wschuma/TeensyLCR/hardware/PCBA/1.1/BOM_TeensyLCR_R1_v1.1.csv

Name | Designator | Footprint | Quantity | Manufacturer Part | Manufacturer
100nF | C1,C2,C3,C4,C5,C6,C7,C8,C9,C10,C11,C12,C21,C22,C23,C24,C25,C26,C27,C28,C31,C34,C35,C39,C43,C58,C59 | C0603 | 27 | CC0603KRX7R9BB104 | YAGEO(国巨)
NP | C13,C14,C15,C16 | C0603 | 4
750pF | C17,C19 | C0603 | 2 | CC0603JRNPO9BN751 | YAGEO(国巨)
180pF | C18,C20 | C0603 | 2 | CC0603JRNPO9BN181 | YAGEO(国巨)
47uF | C29,C32,C37 | CAP-SMD_BD6.3-L6.6-W6.6-LS7.3-FD | 3 | XT47UF50V90RV0082 | KNSCHA(科尼盛)
1uF | C30,C33,C36,C53,C54,C57 | C1206 | 6 | CL31B105KBHNNNE | SAMSUNG(三星)
10uF | C38,C40,C41,C52,C55,C56 | C1206 | 6 | CL31A106KBHNNNE | SAMSUNG(三星)
10nF | C42 | C0603 | 1 | 0603B103K500NT | FH(风华)
33pF | C44,C45 | C0603 | 2 | CL10C120JB8NNNC | SAMSUNG(三星)
2.7nF | C46,C51 | C0603 | 2 | CC0603JRNPO9BN272 | YAGEO(国巨)
470pF | C47,C48,C49,C50 | C0603 | 4 | CC0603JRNPO9BN471 | YAGEO(国巨)
BAV199 | D1,D2,D3,D4,D5 | TSOT23-3 | 5 | BAV199LT1G | onsemi(安森美)
B360A | D6,D7,D8 | SMA_L4.4-W2.6-LS5.0-RD | 3
4-103321-5 | H5,JP2 | HDR-TH_3P-P2.54-V-M | 2 | 4-103321-5 | TE Connectivity(美国泰科)
828214-2 | JP1 | HDR-TH_2P-P2.54-V-M | 1 | 828214-2 | TE Connectivity(美国泰科)
6.8uH | L1,L2 | IND-SMD_L4.0-W4.0 | 2 | YNR4018-6R8M | YJYCOIN(益嘉源)
100Ω@100MHz | L3 | L0805 | 1 | GZ2012D101TF | Sunlord(顺络)
600Z | L4 | L1206 | 1 | L1206 | null
19-213/Y2C-CQ2R2L/3T(CY) | LED1 | LED0603-RD-YELLOW | 1 | 19-213/Y2C-CQ2R2L/3T(CY) | EVERLIGHT(亿光)
19-217/GHC-YR1S2/3T | LED2 | LED0603-RD | 1 | 19-217/GHC-YR1S2/3T | EVERLIGHT(亿光)
1812L014 | PTC1,PTC2,PTC3,PTC4 | F1812 | 4
2N7002 | Q1 | SOT-23-3_L2.9-W1.3-P1.90-LS2.4-BR | 1 | 2N7002 | CJ(江苏长电/长晶)
LBSS84LT1G | Q2 | SOT-23_L2.9-W1.3-P1.90-LS2.4-BR | 1 | LBSS84LT1G | LRC(乐山无线电)
10kΩ | R1,R2,R11,R12,R18,R19 | R0603 | 6 | 0603WAF1002T5E | UNI-ROYAL(厚声)
100Ω | R3,R7,R38 | R0805 | 3 | 0805W8F1000T5E | UNI-ROYAL(厚声)
1kΩ | R4,R8 | R0805 | 2 | 0805W8F1001T5E | UNI-ROYAL(厚声)
10kΩ | R5,R9 | R0805 | 2 | 0805W8F1002T5E | UNI-ROYAL(厚声)
100kΩ | R6,R10 | R0805 | 2 | 0805W8F1003T5E | UNI-ROYAL(厚声)
10kΩ | R13,R14,R15,R16,R20,R21,R22,R23,R34,R35,R36,R37,R41,R67 | R0603 | 14 | RT0603BRD0710KL | YAGEO(国巨)
22Ω | R17 | R0603 | 1 | 0603WAF220JT5E | UNI-ROYAL(厚声)
27kΩ | R24,R70 | R0603 | 2 | RT0603BRD0710KL | YAGEO(国巨)
5.1kΩ | R25,R71 | R0603 | 2 | RT0603BRD072K05L | YAGEO(国巨)
1kΩ | R26,R29 | R0603 | 2 |  | YAGEO(国巨)
330Ω | R27,R28 | R0603 | 2 |  | YAGEO(国巨)
15kΩ | R30,R32 | R0603 | 2 | RT0603BRD0715KL | YAGEO(国巨)
7.5kΩ | R31,R33 | R0603 | 2 | RT0603BRD077K5L | YAGEO(国巨)
13kΩ | R39 | R0603 | 1 | 0603WAF1302T5E | UNI-ROYAL(厚声)
68kΩ | R40 | R0603 | 1 | 0603WAF6802T5E | UNI-ROYAL(厚声)
30.9kΩ | R42 | R0603 | 1 | ARG03FTC3092 | Viking(光颉)
39Ω | R43,R44,R56,R57 | R0603 | 4 | TC0325B390JT5E | UNI-ROYAL(厚声)
560Ω | R45,R53,R54,R58 | R0603 | 4 | RT0603BRD07560RL | YAGEO(国巨)
NP | R46,R47,R48,R49 | R0603 | 4 | 0603WAF1004T5E | UNI-ROYAL(厚声)
1kΩ | R50,R51,R52,R55 | R0603 | 4 | RT0603BRD071KL | YAGEO(国巨)
4.7kΩ | R59,R60 | R0603 | 2 | 0603WAF4701T5E | UNI-ROYAL(厚声)
NP | R61,R62,R63,R64,R65 | R0603 | 5 | 0603WAF1002T5E | UNI-ROYAL(厚声)
1.8kΩ | R68 | R0603 | 1 | 0603WAF1801T5E | UNI-ROYAL(厚声)
470Ω | R69,R72 | R0603 | 2 | 0603WAF4700T5E | UNI-ROYAL(厚声)
1kΩ | R73 | R0603 | 1 | 0603WAF4700T5E | UNI-ROYAL(厚声)
10k | R74,R75 | R0603 | 2 | 0603WAF1002T5E | UNI-ROYAL(厚声)
62kΩ | R76 | R0603 | 1 | 0603WAF6202T5E | UNI-ROYAL(厚声)
8.2kΩ | R77 | R0603 | 1 | RT0603BRD0710KL | YAGEO(国巨)
NO | SB1,SB2,SB3,SB4,SB5 | PAD-JUMPER-2-NO_YES_SILK | 5
5002 | TP1,TP2,TP3,TP4,TP5,TP6,TP7,TP8,TP9,TP10,TP11 | KEYSTONE5002 | 11 |  | Keystone
OPA192ID | U1,U4,U12 | SOIC-8_L4.9-W3.9-P1.27-LS6.0-BL | 3
MAX4582CSE | U2,U3 | SOIC-16_L9.9-W3.9-P1.27-LS6.0-BL | 2 | 74VHC4052N | onsemi(安森美)
MAX4052ACSE | U9,U10 | SOIC-16_L9.9-W3.9-P1.27-LS6.0-BL | 2 | 74VHC4052N | onsemi(安森美)
CS4272-CZZ | U11 | TSSOP-28_L9.7-W4.4-P0.65-LS6.4-TL | 1
M24C02-WMN6TP | U13 | SOIC-8_L4.9-W3.9-P1.27-LS6.0-BL | 1 | M24C02-WMN6TP | ST(意法半导体)
Teensy4.1 | U14 | TEENSY4.1 | 1 | Teensy4.1 | PJRC
ADP2301 | U15,U19 | TSOT-23-6_L2.9-W1.6-P0.95-LS2.8-BL | 2 | ADP2301AUJZ-R7 | ADI
LT1962 | U17 | MSOP-8 | 1
AMS1117-5.0 | U18 | SOT-223_L6.5-W3.5-P2.30-LS7.0-BR_ST_VNL5050N3TR-E | 1 | AMS1117-5.0 | AMS
TCN75AVOA | U20 | SOIC-8_L4.9-W3.9-P1.27-LS6.0-BL | 1 | TCN75AVOA | MICROCHIP(美国微芯)
5414907-1 | X1,X2,X3,X4 | BNC-TH_5414907-1 | 4 | 5414907-1 | TE Connectivity(美国泰科)
DC-005-5A-2.0 | X5 | DC-IN-TH_DC-005-5A-2.0 | 1 | DC-005-5A-2.0 | XKB Enterprise
MKDSN1.5/2-5.08 | X6 | CONN-TH_2P-P5.08 | 1 | 1729128 | Phoenix Contact(菲尼克斯)
0423751867 | X7 | HDR-TH_14P-P2.54-V-M | 1 | 0423751867 | MOLEX
827261-8 | X8 | HDR-TH_8P-P2.54-V-M | 1 | 827261-8 | TE Connectivity(美国泰科)
5-146282-5 | X9 | HDR-TH_5P-P2.54-V-M | 1 | 5-146282-5 | TE Connectivity(美国泰科)
0022102041 | X10 | HDR-TH_4P-P2.54-V-M | 1 | 0022102041 | MOLEX
0878910609 | X11 | HDR-TH_6P-P2.54-V-M | 1 | 0878910609 | MOLEX
24.576MHz | Y1 | CRYSTAL-TXC-7A | 1
OPA2192ID | U5,U6 | SOIC-8_L4.9-W3.9-P1.27-LS6.0-BL | 2 | OPA2376AIDR | TI(德州仪器)
AD8032ARZ | U7,U8 | SOIC-8_L4.9-W3.9-P1.27-LS6.0-BL | 2 | OPA2376AIDR | TI(德州仪器)
THS4522IPW | U16 | TSSOP-16_L5.0-W4.4-P0.65-LS6.4-TL | 1
