wschuma/TeensyLCR/hardware/PCBA/1.1/Schematic_TeensyLCR_R1_v1.1.pdf

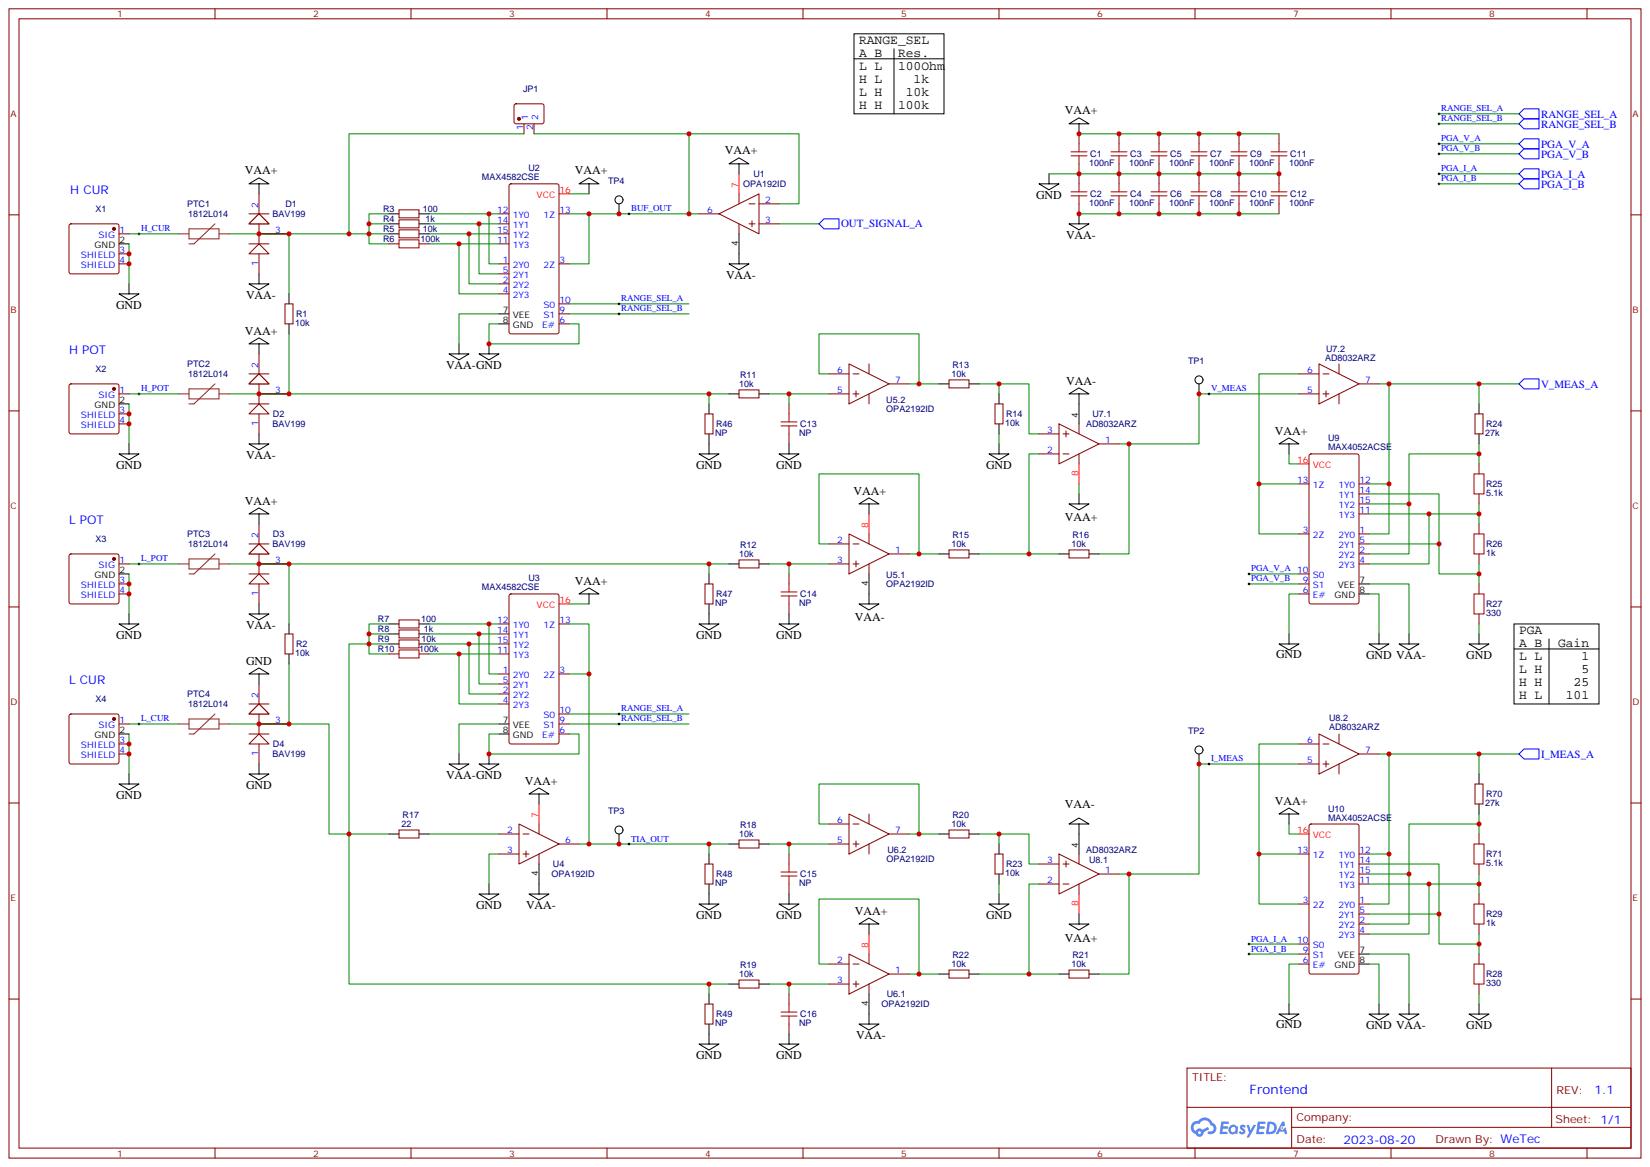
[picture p5: page 1]

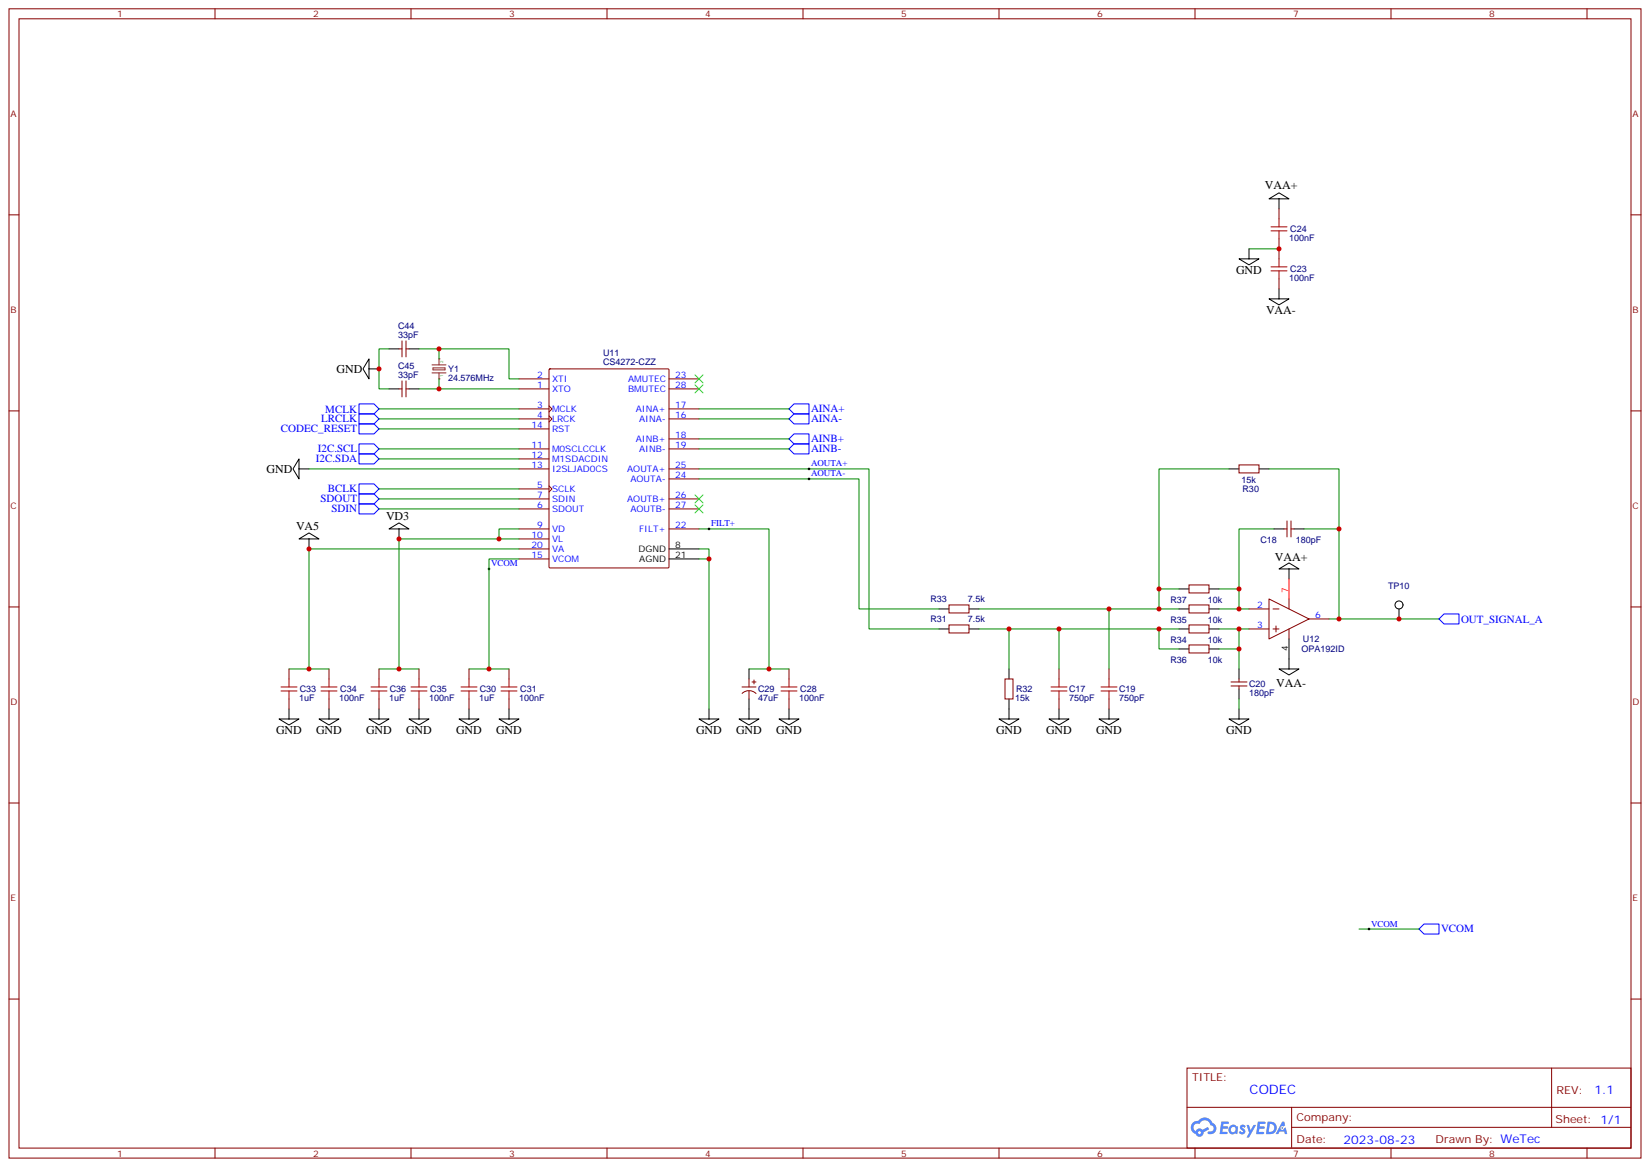
[picture p6: page 2]

# VD5 rail

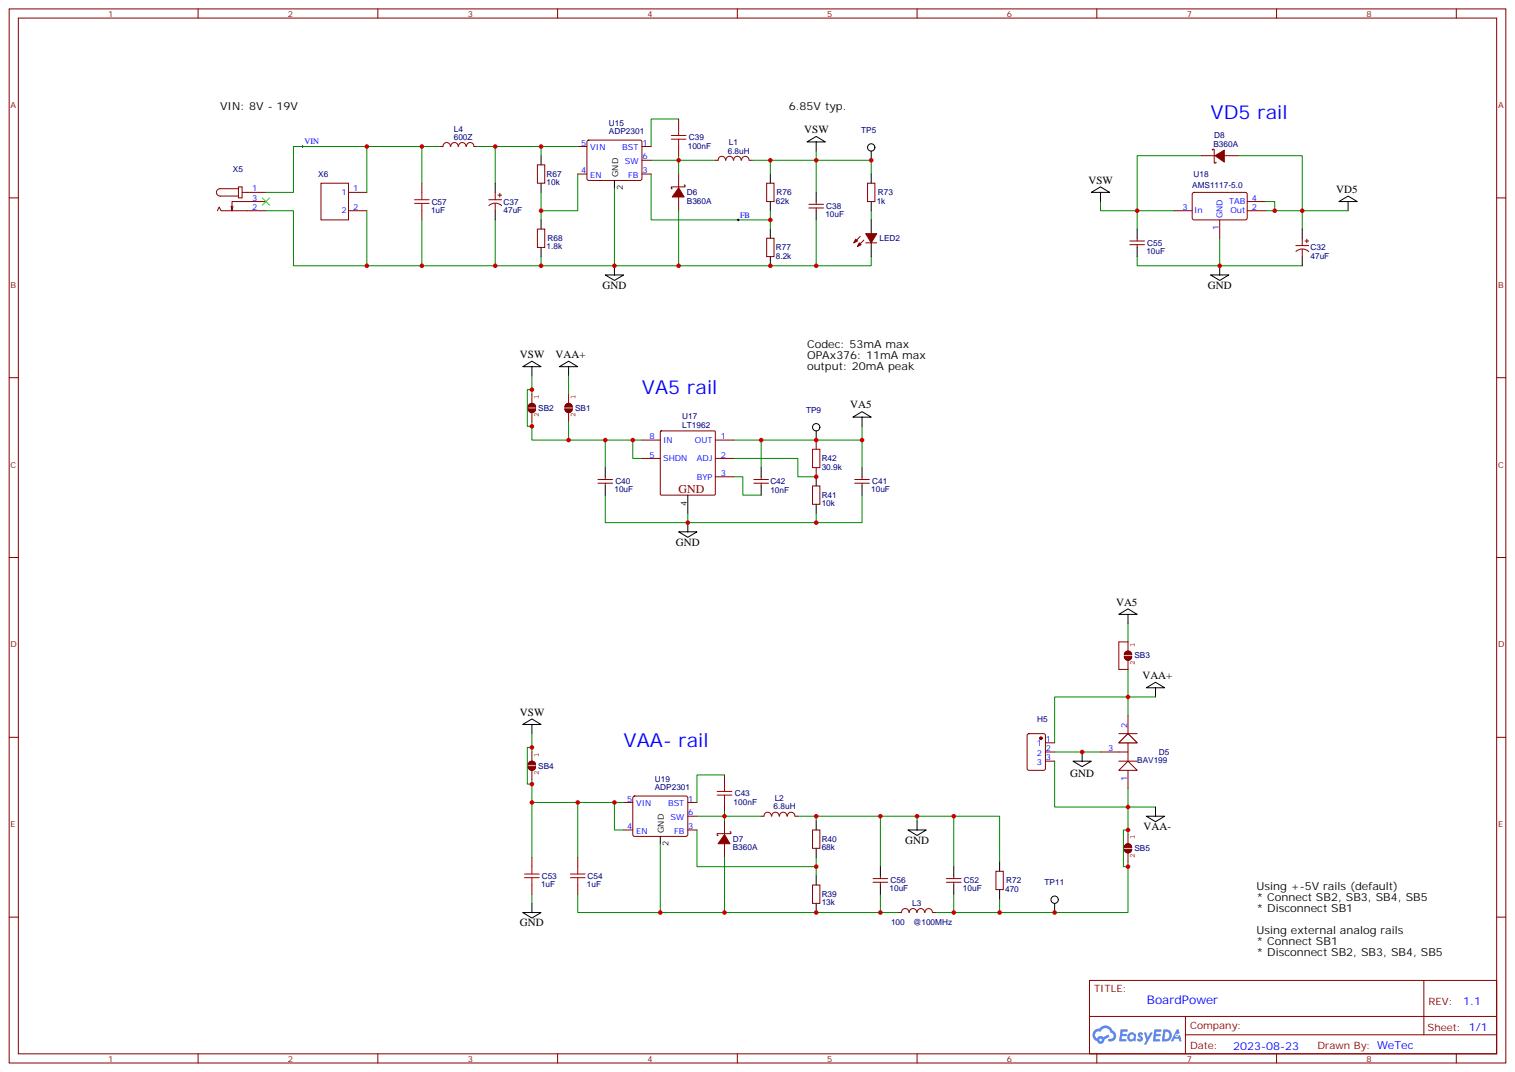
[picture p7: page 3]

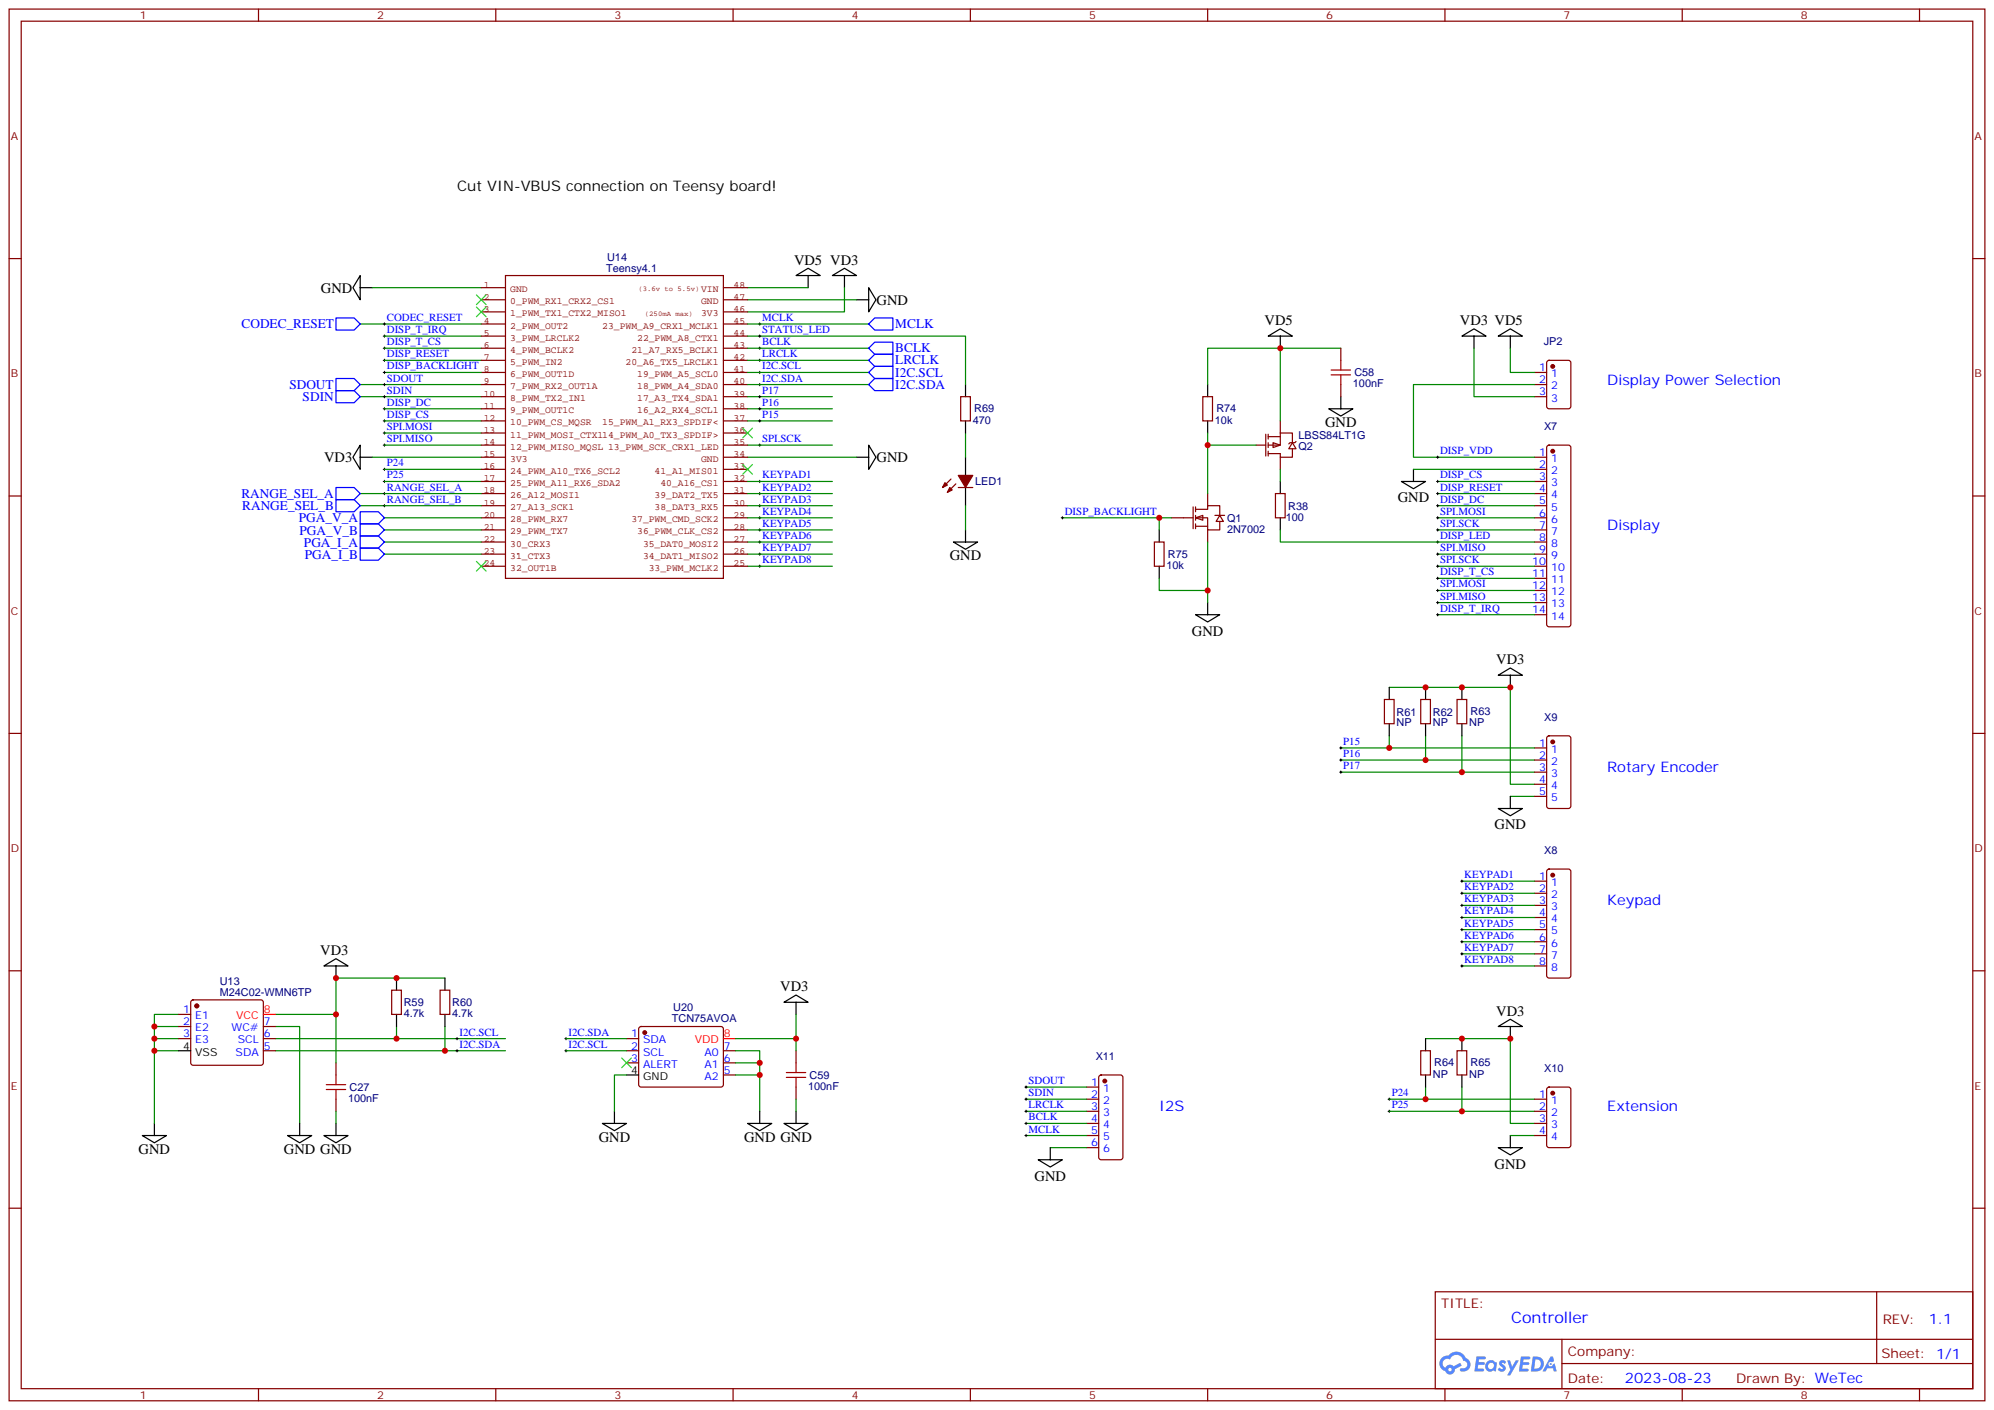
[picture p8: page 4]

Cut VIN-VBUS connection on Teensy board!

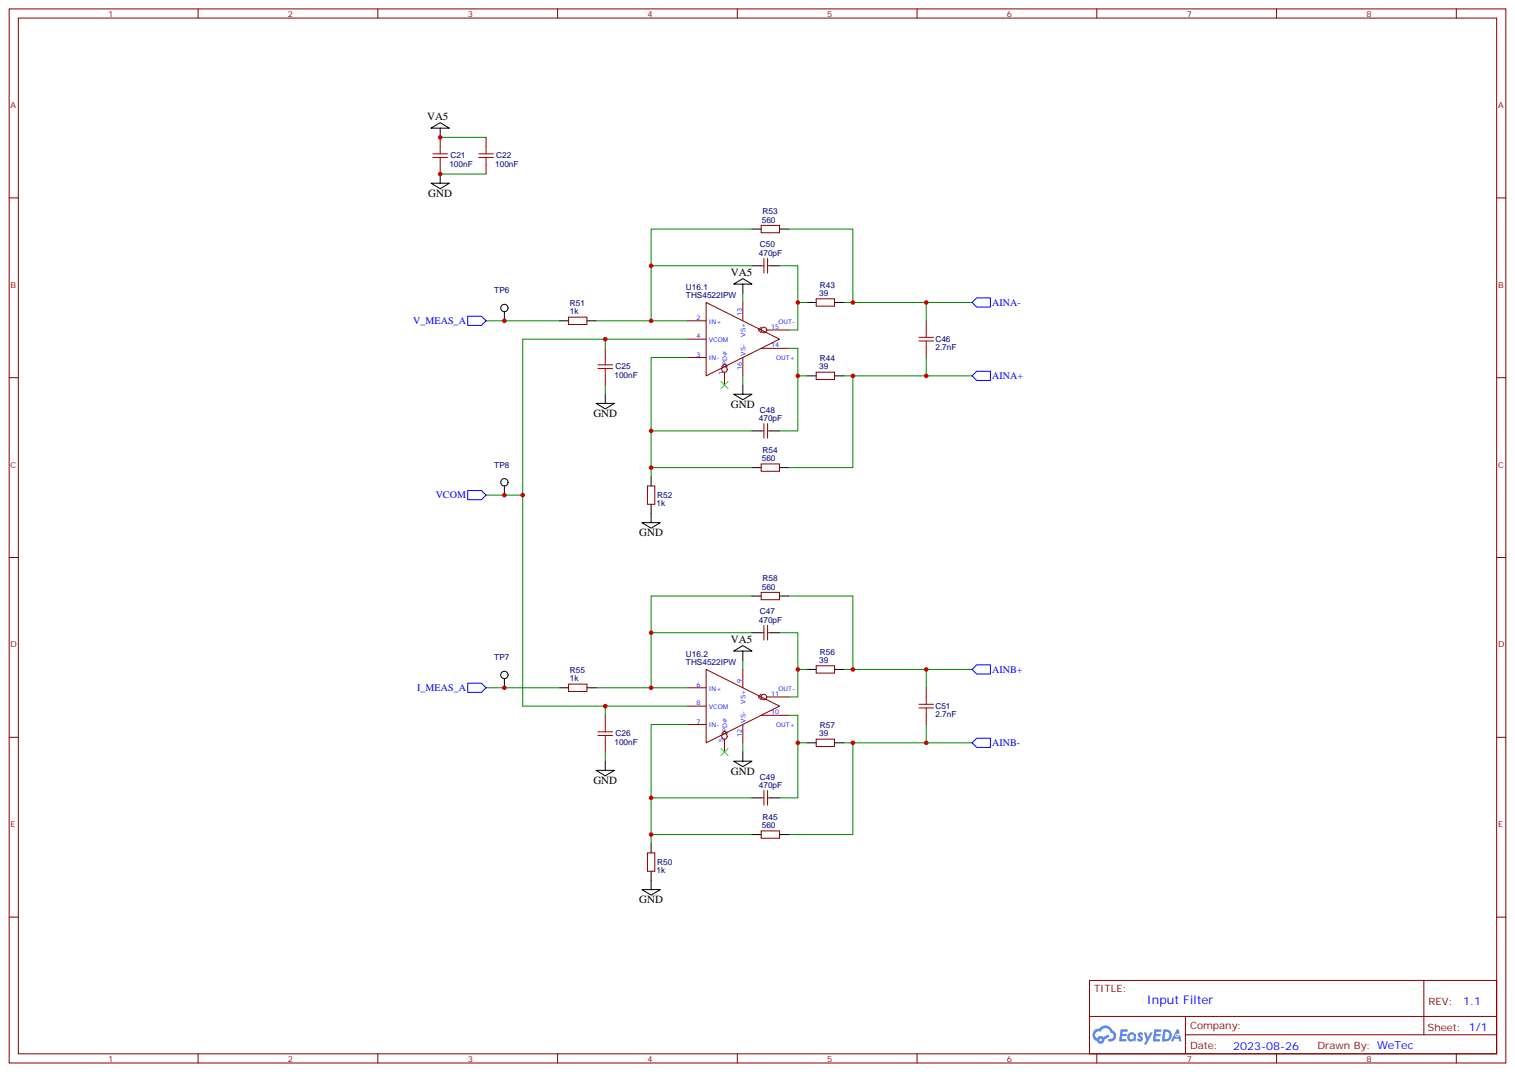
[picture p9: page 5]
