wschuma/TeensyLCR/hardware/PCBA/1.0/Schematic_TeensyLCR_R1_v1.0.pdf

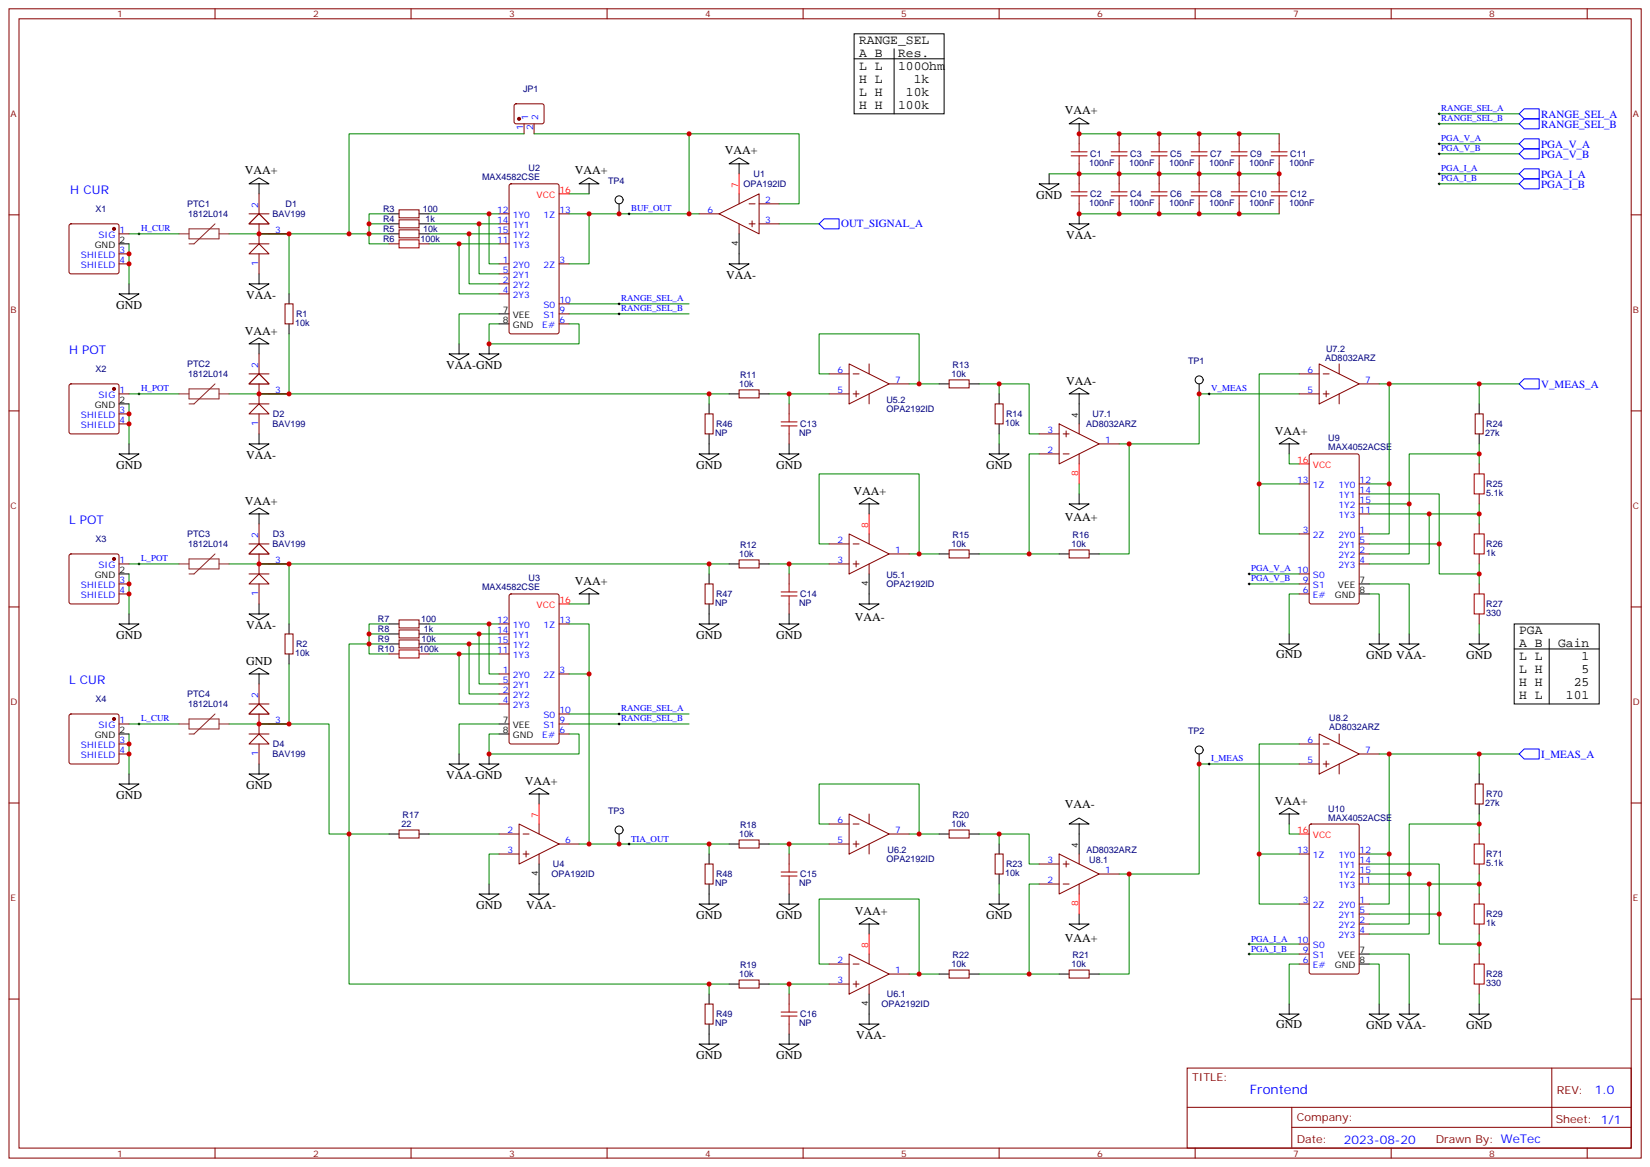
[picture p10: page 1]

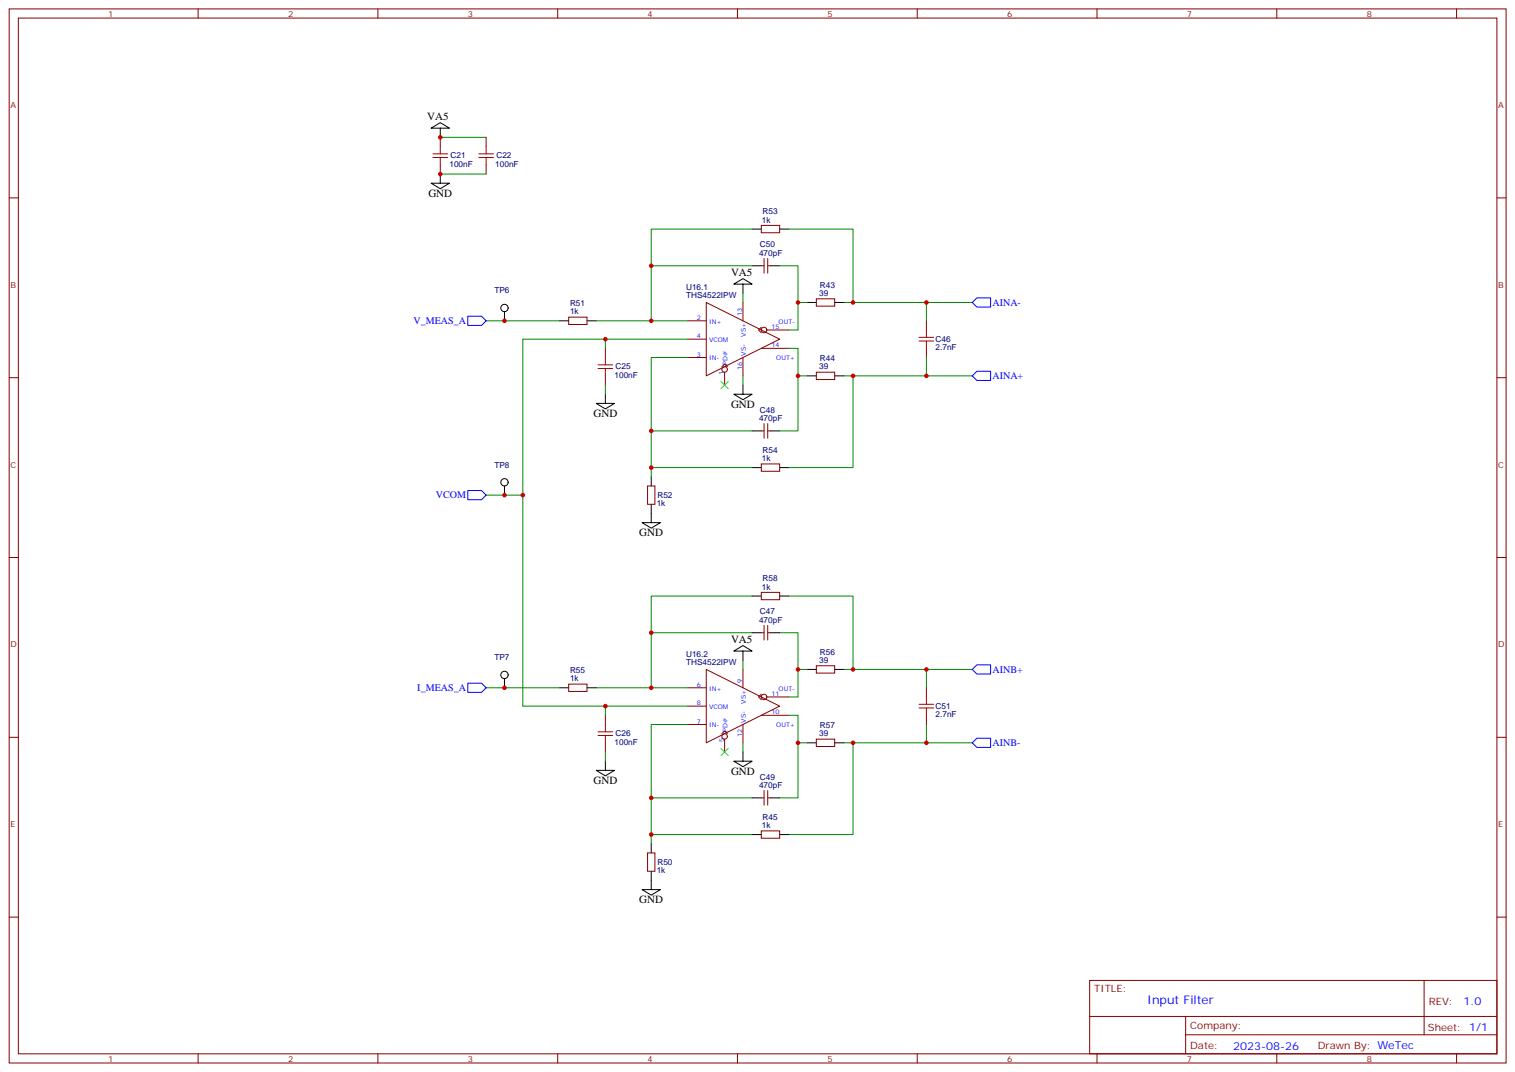
[picture p11: page 2]

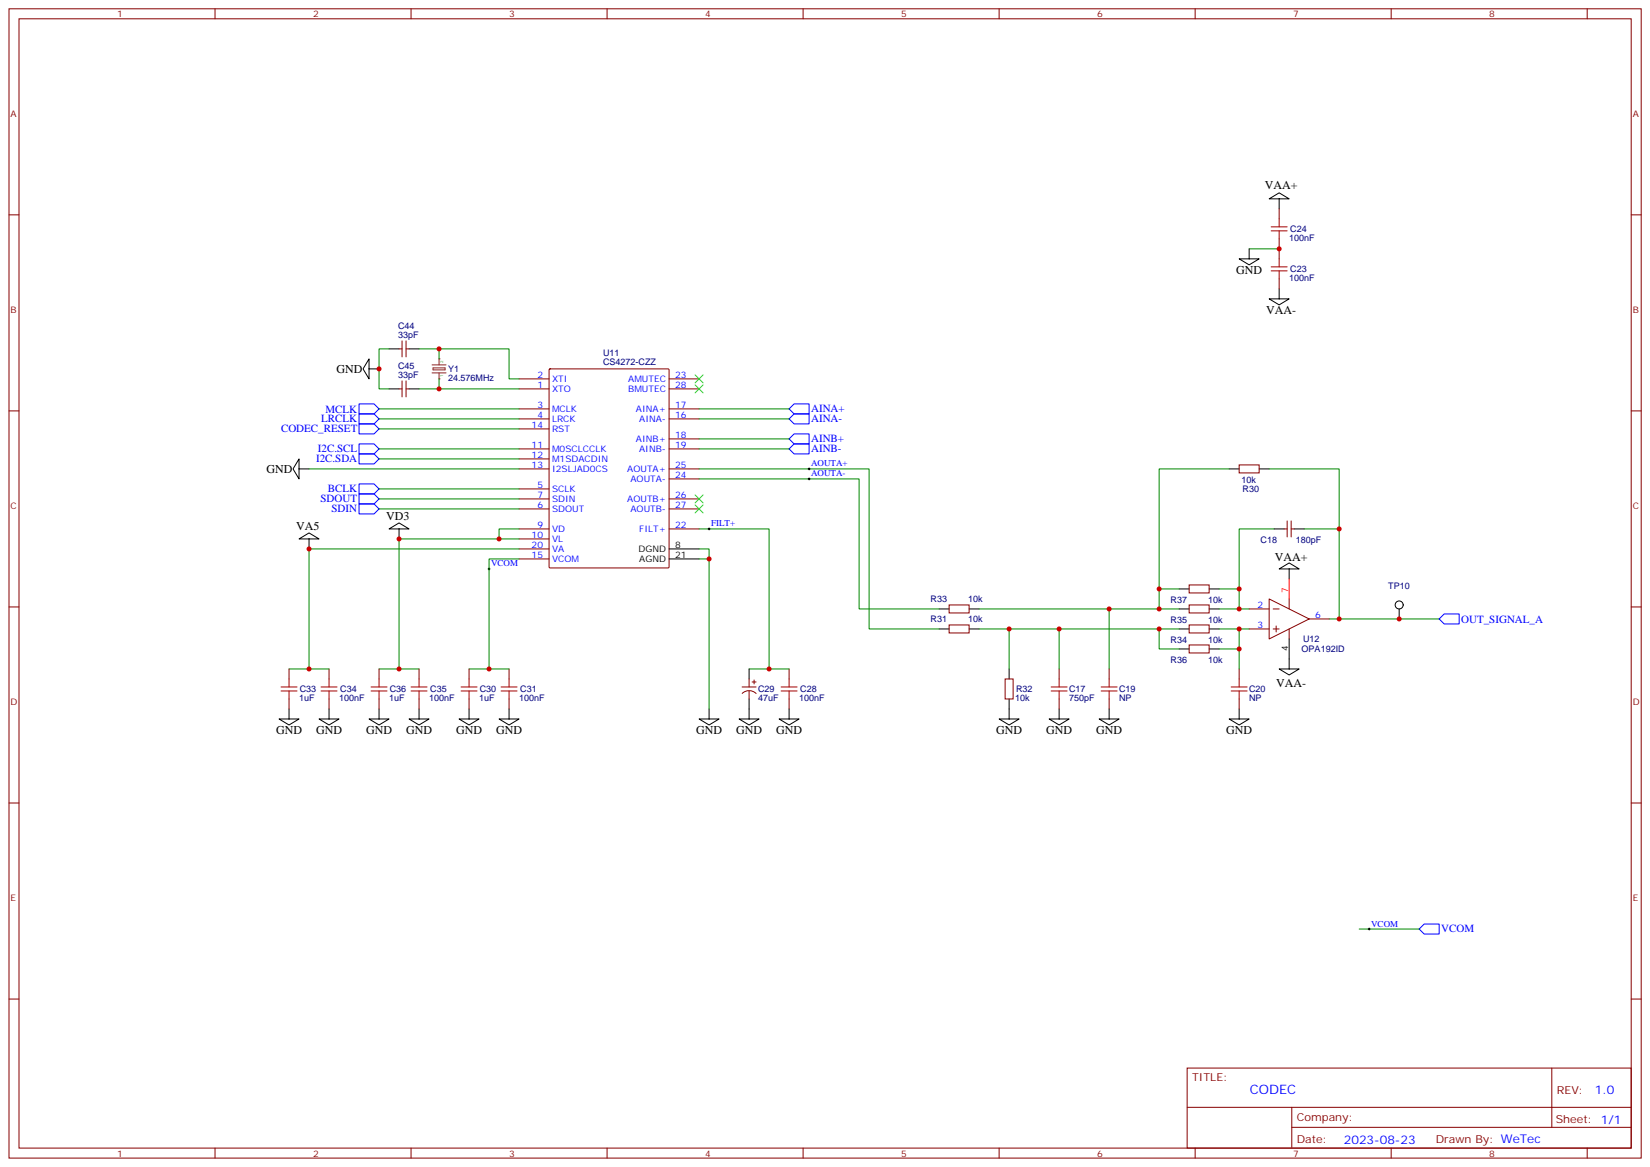
[picture p12: page 3]

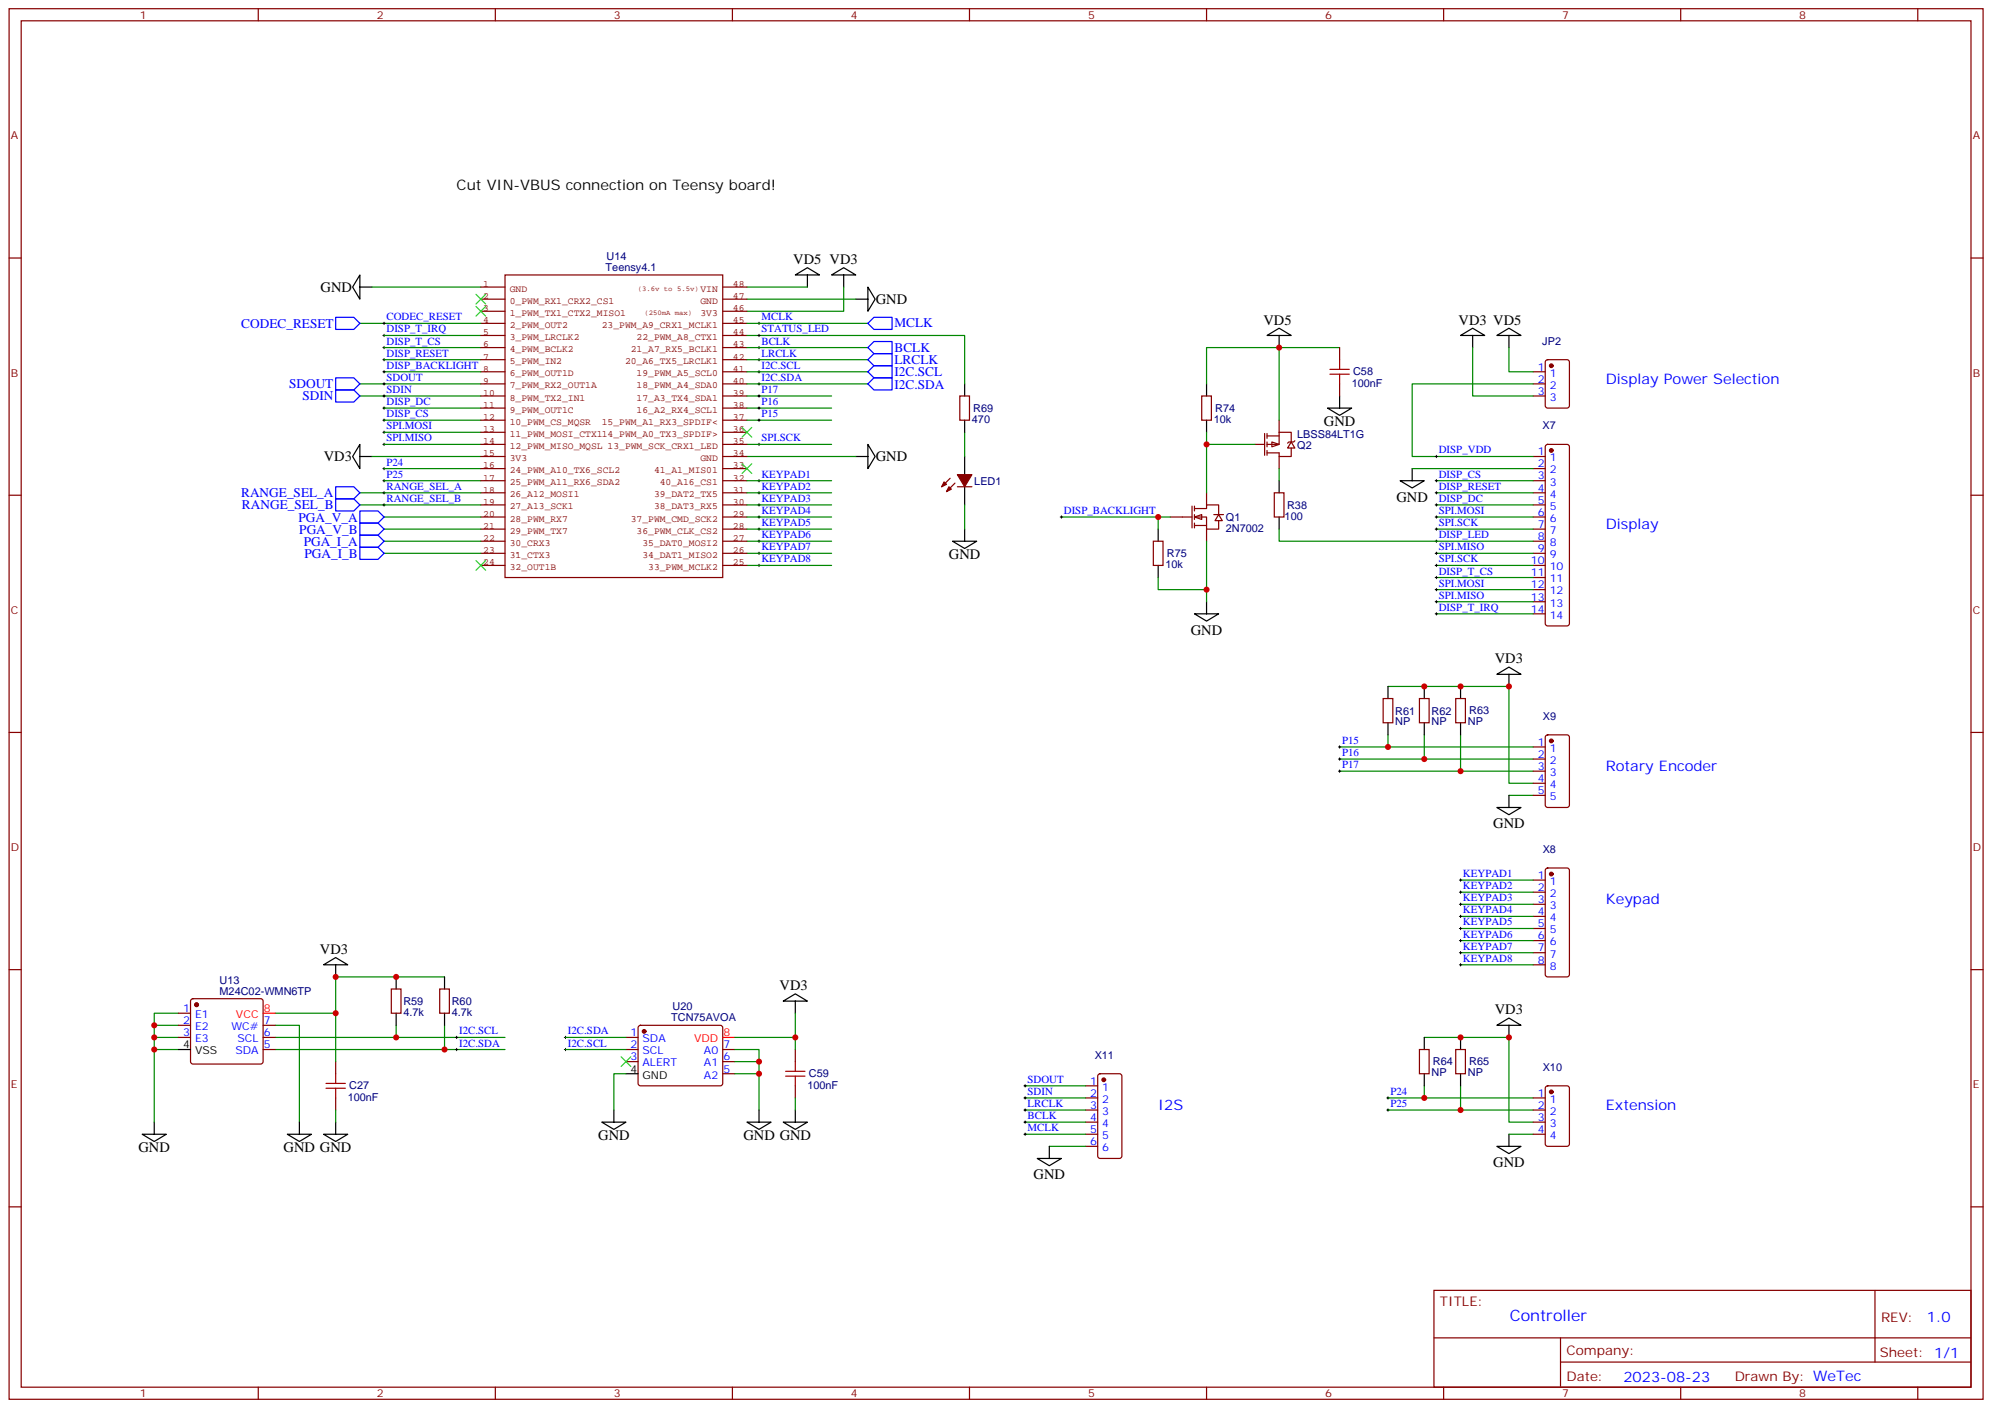
[picture p13: page 4]

Cut VIN-VBUS connection on Teensy board!

# VD5 rail

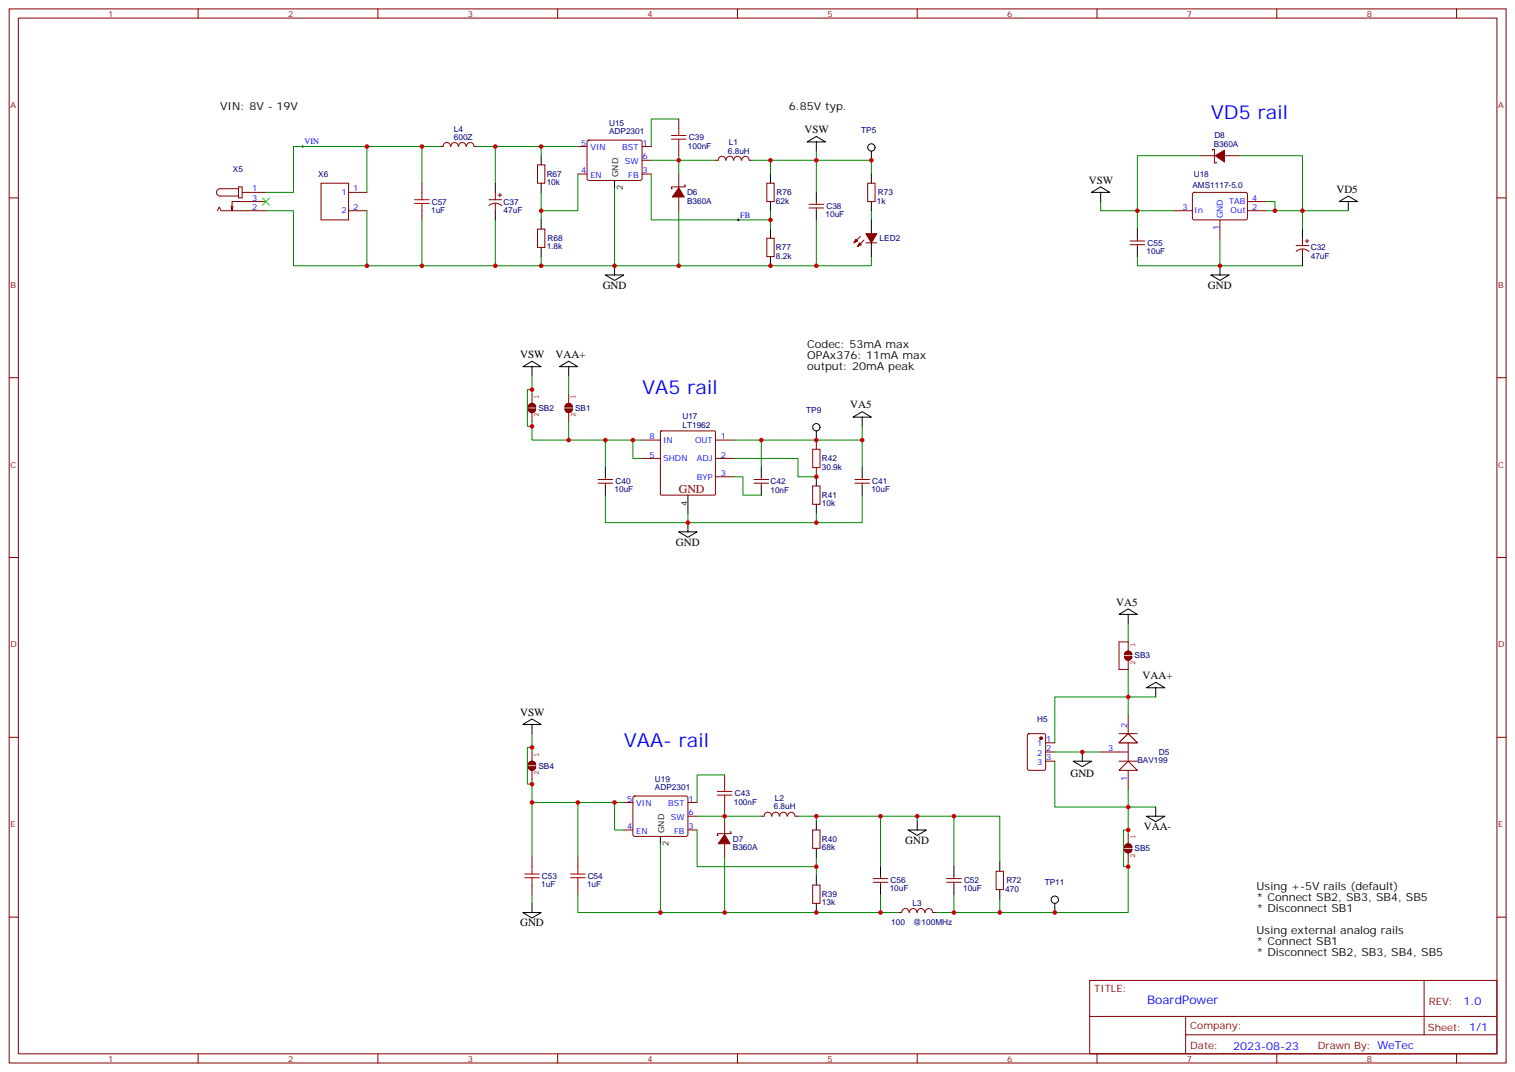
[picture p14: page 5]
