wschuma/TeensyLCR/func_lcr.cpp

#include "apps.h"
#include <Arduino.h>
#include "audio_design.h"
#include "autorange.h"
#include "board.h"
#include "CComplex.h"
#include "correction.h"
#include "displayhelp.h"
#include "func_lcr.h"
#include "globals.h"
#include "helper.h"
#include <ili9341_t3n_font_Arial.h>
#include "lcr_param.h"
#include "lcr_setup.h"
#include "settings.h"
#include "src/utils/btn_bar_menu.h"
#include "sweep.h"
#include "sysmenu.h"

static const uint8_t PRIMARY = 0;
static const uint8_t SECONDARY = 1;

bool forceRanging = false;

// Menu definition
BtnBarMenu lcrMenu(&tft);
BtnBarMenu lcrSetFreqMenu(&tft);
BtnBarMenu lcrSetLevelMenu(&tft);

const char *functionLabelSelection;

const char *displModeLabels[] = {"Normal", "Debug"};
const char *displModeLabelSelection;

const char *rangeModeLabels[] = {"Auto", "Hold"};
const char *rangeModeLabelSelection;

const char *offOnLabels[] = {"OFF", "ON"};
const char *corrLabelSelection;
bool applyCorrection = false;

char avgStr[6];

File waveFile;

void lcrDrawFuncIndicators()
{
  // skip if debug display
  if (lcrSettings.displMode != 0)
    return;

  tft.fillRect(0, MAIN_DISPLAY_Y_PRIMARY, 31, 14, ILI9341_BLACK);
  tft.setFont(Arial_14);
  tft.setTextColor(ILI9341_GREEN);
  tft.setCursor(0, MAIN_DISPLAY_Y_PRIMARY);
  tft.print(lcrParams[lcrSettings.function][PRIMARY]->label);

  tft.fillRect(0, MAIN_DISPLAY_Y_SECONDARY, 31, 14, ILI9341_BLACK);
  tft.setCursor(0, MAIN_DISPLAY_Y_SECONDARY);
  tft.print(lcrParams[lcrSettings.function][SECONDARY]->label);
}

void lcrUpdateCorrState()
{
  if (lcrSettings.applyCorrection && (corr_data.ts_open > 0 || corr_data.ts_short > 0))
  {
    corrLabelSelection = offOnLabels[1];
    applyCorrection = true;
  } else {
    corrLabelSelection = offOnLabels[0];
    applyCorrection = false;
  }
}

void lcrDrawMeasSetup()
{
  // skip if debug display
  if (lcrSettings.displMode != 0)
    return;

  static const uint MEAS_SETUP_LINE1_Y = 123;
  static const uint MEAS_SETUP_LINE2_Y = 145;

  // clear area
  tft.fillRect(0, MEAS_SETUP_LINE1_Y, 320, 40, ILI9341_BLACK);
  // draw labels
  tft.setFont(Arial_14);
  tft.setTextColor(ILI9341_GREEN);
  tft.setCursor(0, MEAS_SETUP_LINE1_Y);
  tft.print("FREQ:");
  tft.setCursor(0, MEAS_SETUP_LINE2_Y);
  tft.print("LEVEL:");
  tft.setCursor(163, MEAS_SETUP_LINE1_Y);
  tft.print("RANGE:");
  //tft.print("FUNC:");
  tft.setCursor(163, MEAS_SETUP_LINE2_Y);
  tft.print("CORR:");

  // draw values
  tft.setTextColor(ILI9341_WHITE);

  tft.setCursor(72, MEAS_SETUP_LINE1_Y);
  if (lcrSettings.frequency < 1000) {
    tft.print(lcrSettings.frequency, 0);
    tft.print(" Hz");
  } else {
    tft.print(lcrSettings.frequency / 1000, 2);
    tft.print(" kHz");
  }

  tft.setCursor(72, MEAS_SETUP_LINE2_Y);
  tft.print(lcrSettings.level, 3);
  tft.print(" V");

  tft.setCursor(244, MEAS_SETUP_LINE1_Y);
  //tft.print(functionLabels[lcrSettings.function]);
  tft.print("[");
  tft.print(board.getLCRRange());
  tft.print("] ");
  tft.print(rangeModeLabels[lcrSettings.range_mode]);

  tft.setCursor(244, MEAS_SETUP_LINE2_Y);
  tft.print(corrLabelSelection);
}

void calc_lcr() {
  static const float LCR_THRESHOLD_OPEN = 100e6; // Ohm

  // determain lcr meter range
  bool hold = lcrSettings.range_mode == 1;
  RangingState state = autoRange(hold, forceRanging);
  switch (state) {
    case (RangingState::Started):
      // ranging started
      forceRanging = false;
      drawPrimaryDisplay(" -----");
      drawSecondaryDisplay(" -----");
      return;
    case (RangingState::Active):
      // ranging is active, readings are not valid yet
      return;
    case (RangingState::Finished):
      // finished ranging, restore averaging
      adSetMinAveraging(lcrSettings.minAveraging);
      lcrDrawMeasSetup();
      return;
    default:
      // active range is ok, show results
      break;
  }

  float impedance = adReadings.v_rms / adReadings.i_rms;
  float phase = adReadings.phase;

  if (applyCorrection)
    corrApply(&impedance, &phase, lcrSettings.frequency);

  if (impedance > LCR_THRESHOLD_OPEN)
  {
    drawPrimaryDisplay(" Open");
    drawSecondaryDisplay("");
    return;
  }

  Complex z;
  z.polar(impedance, phase);
  disp_val_t val;
  
  float value = lcrParams[lcrSettings.function][PRIMARY]->value(z, lcrSettings.frequency);
  int8_t resolution = lcrParams[lcrSettings.function][PRIMARY]->resolution;
  getDisplValue(value, 5, resolution, &val);
  val.unit = lcrParams[lcrSettings.function][PRIMARY]->unit;
  drawPrimaryDisplay(&val);
  
  value = lcrParams[lcrSettings.function][SECONDARY]->value(z, lcrSettings.frequency);
  resolution = lcrParams[lcrSettings.function][SECONDARY]->resolution;
  // show only 4 Phi (deg) digits
  if (lcrSettings.function == 11)
    getDisplValue(value, 4, resolution, &val);
  else
    getDisplValue(value, 5, resolution, &val);
  val.unit = lcrParams[lcrSettings.function][SECONDARY]->unit;
  drawSecondaryDisplay(&val);
}

void calc_lcr2() {
  tft.fillRect(0, 0, 320, tft.height() - 69, ILI9341_BLACK);
  tft.setFont();
  tft.setTextSize(2);
  tft.setTextColor(ILI9341_GREEN);
  tft.setCursor(0, 0);

  // determain lcr meter range
  bool hold = lcrSettings.range_mode == 1;
  RangingState state = autoRange(hold, forceRanging);
  switch (state) {
    case (RangingState::Started):
      // ranging started
      forceRanging = false;
      break;
    case (RangingState::Finished):
      // finished ranging, restore averaging
      adSetMinAveraging(lcrSettings.minAveraging);
      break;
    default:
      // active range is ok, show results
      break;
  }

  float impedance = adReadings.v_rms / adReadings.i_rms;
  float phase = adReadings.phase;
  disp_val_t val;
  Complex z;
  z.polar(impedance, phase);
  
  if (applyCorrection)
    corrApply(&impedance, &phase, lcrSettings.frequency);

  char buf[25];
  tft.print("h V= ");
  tft.print(adHeadroom(adReadings.v_peak));
  tft.print("dB I= ");
  tft.print(adHeadroom(adReadings.i_peak));
  tft.println("dB");

  sprintf(buf, "V rms= %+E", adReadings.v_rms);
  tft.println(buf);
  sprintf(buf, "I rms= %+E", adReadings.i_rms);
  tft.println(buf);
  sprintf(buf, "V mean= %+E", adReadings.v_mean);
  tft.println(buf);
  sprintf(buf, "I mean= %+E", adReadings.i_mean);
  tft.println(buf);
  
  sprintf(buf, "Z= %+E", impedance);
  tft.println(buf);
  tft.print("Phi= ");
  tft.println(phase / PI * 180, 3);
  
  sprintf(buf, "Rs= %+E", z.real());
  tft.println(buf);
  
  tft.print(adBlocksToAnalyze);
  tft.print(" ");
  tft.println(adGetAveraging());
  
  tft.print("Gv:");
  tft.print(board.getPGAGainV());
  tft.print(" Gi:");
  tft.print(board.getPGAGainI());
  tft.print(" R:");
  tft.print(board.getLCRRange());
  if (hold)
    tft.print("H");

  if (state == RangingState::Active)
    tft.println(" ranging");
}

void lcrDrawMenu()
{
  if (activeMenu == APP_DEFAULT)
    lcrMenu.draw();
  else if (activeMenu == SELECT_FUNCTION)
    appSelectMenu.draw();
  else if (activeMenu == LCR_SET_FREQUENCY)
    lcrSetFreqMenu.draw();
  else if (activeMenu == LCR_SET_LEVEL)
    lcrSetLevelMenu.draw();
  
  osdMessage.show();
  tft.updateScreen();
  osdMessage.clean();
}

void lcrResetScreen()
{
  tft.fillScreen(ILI9341_BLACK);
  lcrDrawFuncIndicators();
  lcrDrawMeasSetup();
  lcrDrawMenu();
}

void lcrSetAveraging()
{
  tft.fillScreen(ILI9341_BLACK);
  tft.setFont(Arial_14);
  tft.setTextColor(ILI9341_WHITE);
  tft.setCursor(0, 0);
  tft.println("Minimum Averaging:");
  uint avg;
  bool ok = enterNr(&avg, 1, 255);
  if (ok)
  {
    lcrSettings.minAveraging = avg;
    adSetMinAveraging(lcrSettings.minAveraging);
    sprintf(avgStr, "%i", avg);
  }
  lcrResetScreen();
}

void lcr_select_func()
{
  lcrSettings.function = get_list_entry(functionLabels, LCR_FUNC_NUM, lcrSettings.function);
  functionLabelSelection = functionLabels[lcrSettings.function];
  lcrResetScreen();
}

void lcrSetFrequency(float f)
{
  if (f == 0) {
    f = enterFrequency(LCR_MIN_FREQUENCY, LCR_MAX_FREQUENCY, "Enter frequency:");
    f = f / LCR_FREQ_RESOLUTION; // set last digit to 0
    f = (uint)round(f) * LCR_FREQ_RESOLUTION;
  }
  if (f > 0) {
    lcrSettings.frequency = f;
    adSetOutputFrequency(lcrSettings.frequency);
    forceRanging = true;
  }
  activeMenu = APP_DEFAULT;
  lcrResetScreen();
}

void lcrShowSelectFreqMenu()
{
  activeMenu = LCR_SET_FREQUENCY;
  lcrDrawMenu();
}

void lcrSetFreq100()
{
  lcrSetFrequency(100);
}

void lcrSetFreq1k()
{
  lcrSetFrequency(1000);
}

void lcrSetFreq10k()
{
  lcrSetFrequency(10000);
}

void lcrSetFreqMan()
{
  lcrSetFrequency(0);
}

void lcrSetLevel(float level)
{
  if (level == 0) {
    level = enterVoltage(LCR_MIN_LEVEL, LCR_MAX_LEVEL);
    level = level / LCR_LEVEL_RESOLUTION;
    level = (uint)round(level) * LCR_LEVEL_RESOLUTION;
  }
  if (level > 0) {
    lcrSettings.level = level;
    adSetOutputAmplitude(level * sqrtf(2));
    forceRanging = true;
  }
  activeMenu = APP_DEFAULT;
  lcrResetScreen();
}

void lcrShowSelectLevelMenu()
{
  activeMenu = LCR_SET_LEVEL;
  lcrDrawMenu();
}

void lcrSetLevel300()
{
  lcrSetLevel(0.3);
}

void lcrSetLevel600()
{
  lcrSetLevel(0.6);
}

void lcrSetLevel1()
{
  lcrSetLevel(1.0);
}

void lcrSetLevelMan()
{
  lcrSetLevel(0);
}

void lcrSetDisplayMode()
{
  lcrSettings.displMode = ++lcrSettings.displMode % 2;
  displModeLabelSelection = displModeLabels[lcrSettings.displMode];
  if (lcrSettings.displMode == 0) {
    tft.fillRect(0, 0, 320, tft.height() - 60, ILI9341_BLACK);
    lcrDrawFuncIndicators();
    lcrDrawMeasSetup();
  }
  lcrDrawMenu();
}

void lcrSetRangeMode()
{
  lcrSettings.range_mode = ++lcrSettings.range_mode % 2;
  rangeModeLabelSelection = rangeModeLabels[lcrSettings.range_mode];
  lcrDrawMeasSetup();
  lcrDrawMenu();
}

void lcrApplySettings()
{
  adSetMinAveraging(lcrSettings.minAveraging);
  sprintf(avgStr, "%i", lcrSettings.minAveraging);
  functionLabelSelection = functionLabels[lcrSettings.function];
  rangeModeLabelSelection = rangeModeLabels[lcrSettings.range_mode];
  displModeLabelSelection = displModeLabels[lcrSettings.displMode];
  lcrUpdateCorrState();

  adSetOutputAmplitude(lcrSettings.level * sqrtf(2));
  adSetOutputOffset(0);

  adSetOutputFrequency(lcrSettings.frequency);
}

void lcrCorrectionMenu()
{
  correctionMenu();
  lcrSettings.range_mode = 0;
  lcrApplySettings();
  lcrResetScreen();
}

void lcrSweepMenu()
{
  sweepPage();
  lcrSettings.range_mode = 0;
  lcrApplySettings();
  lcrResetScreen();
}

void lcrHandleButtons() {
  char key = keypad.getKey();
  if (!key)
    return;
  switch (key) {
    case '1':
      activeMenu = APP_DEFAULT;
      lcrDrawMenu();
      break;
    case '2':
      activeMenu = SELECT_FUNCTION;
      lcrDrawMenu();
      break;
    case '3':
      sysMenuShow();
      lcrResetScreen();
      break;
    case 'S':
      saveScreenshot(&tft);
      break;
    case 'L':
      board.increaseVGain();
      adResetReadings();
      break;
    case 'R':
      board.increaseIGain();
      adResetReadings();
      break;
    case 'C':
      board.setLCRRange((board.getLCRRange() + 1) % LCR_RANGE_NUM);
      adResetReadings();
      break;
    default:
      break;
  }
}

bool lcrHandleTouch()
{
  TS_Point p;
  char key;
  if (!getTouchPoint(&p))
    return false;
    
  if (activeMenu == APP_DEFAULT) {
    lcrMenu.processTSPoint(p);
    return false;
  }
  else if (activeMenu == SELECT_FUNCTION) {
    key = appSelectMenu.processTSPoint(p);
    if (key != BTN_BAR_MENU_EVENT_IDLE) {
      appId = key;
      return true;
    }
  }
  else if (activeMenu == LCR_SET_FREQUENCY) {
    lcrSetFreqMenu.processTSPoint(p);
  }
  else if (activeMenu == LCR_SET_LEVEL) {
    lcrSetLevelMenu.processTSPoint(p);
  }
  return false;
}

void lcrApplication()
{
  // setup
  static const uint DISPLAY_UPDATE_RATE_MIN = 200;  // ms
  static elapsedMillis displayUpdate = 0;
  const char *avgStrPtr = &avgStr[0];
  lcrApplySettings();
  
  lcrMenu.init(btn_feedback, "LCR Menu");
  lcrMenu.add("Freq.", lcrShowSelectFreqMenu);
  lcrMenu.add("Level", lcrShowSelectLevelMenu);
  lcrMenu.add("Function", &functionLabelSelection, lcr_select_func);
  lcrMenu.add("Range", &rangeModeLabelSelection, lcrSetRangeMode);
  lcrMenu.add("Corr.", lcrCorrectionMenu);
  lcrMenu.add("Sweep", lcrSweepMenu);
  lcrMenu.add("Avg.", &avgStrPtr, lcrSetAveraging);
  lcrMenu.add("Display", &displModeLabelSelection, lcrSetDisplayMode);

  lcrSetFreqMenu.init(btn_feedback, "Set Frequency");
  lcrSetFreqMenu.add("100Hz", lcrSetFreq100);
  lcrSetFreqMenu.add("1kHz", lcrSetFreq1k);
  lcrSetFreqMenu.add("10kHz", lcrSetFreq10k);
  lcrSetFreqMenu.add("Manuell", lcrSetFreqMan);

  lcrSetLevelMenu.init(btn_feedback, "Set Level");
  lcrSetLevelMenu.add("300 mV", lcrSetLevel300);
  lcrSetLevelMenu.add("600 mV", lcrSetLevel600);
  lcrSetLevelMenu.add("1 V", lcrSetLevel1);
  lcrSetLevelMenu.add("Manuell", lcrSetLevelMan);

  lcrResetScreen();
  
  // loop
  while (1)
  {
    lcrHandleButtons();
    if (lcrHandleTouch())
      return;
    adAverageReadings();

    if (displayUpdate >= DISPLAY_UPDATE_RATE_MIN && adDataAvailable)
    {
      adDataAvailable = false;
      displayUpdate = 0;
      osdMessage.clean();
      if (lcrSettings.displMode == 0)
        calc_lcr();
      else
        calc_lcr2();

      osdMessage.show();
      tft.updateScreen();
    }
  }
}
