wschuma/TeensyLCR/(commit log)

2024-04-07 Fixed includes and typos
    [displayhelp.cpp, displayhelp.h, func_lcr.cpp]
2024-04-12 Added Schematic
2024-04-13 Added R1 gerber files
2024-04-14 Added BOM
    [BOM_TeensyLCR_R1_2024-04-14.csv]
2024-12-21 moved printDigits() to displayhelp
2025-01-01 added correction function
    removed unused cmplx_helper files
    [correction.cpp, correction.h, displayhelp.cpp, displayhelp.h, func_lcr.cpp]
2025-01-05 Refactor ButtonBarMenu to use callbacks
2025-01-19 setting the output frequency takes care of resetting square wave phase
    [audio_design.h, func_lcr.cpp]
2025-01-19 fix inaccurate correction measurement if range needs to be changed
    [autorange.cpp, correction.cpp, func_lcr.cpp]
2025-02-27 correction over preset frequencies
    [correction.cpp, correction.h, func_lcr.cpp, sweep.cpp]
2025-03-02 rework audio block averaging
    - minimum resolution and output frequency is now 10 Hz
    - more correction and sweep points
    [TeensyLCR.ino, audio_design.h, autorange.cpp, calibration.cpp, correction.cpp, correction.h, displayhelp.h]
2025-03-02 rework frequency input page
    - added "Hz" and "kHz" buttons
    [displayhelp.cpp, displayhelp.h, func_lcr.cpp, sweep.cpp]
2025-03-02 move correction apply setting to LCR settings
    [correction.cpp, correction.h, func_lcr.cpp, lcr_setup.cpp, lcr_setup.h, sweep.cpp]
2025-03-02 save correction data to EEPROM
    [correction.cpp, settings.cpp, settings.h]
2025-03-02 add some EEPROM helper functions
    - used to exchange content between I2C and Teensy internal EEPROM
2025-03-11 remove printCalData()
2025-03-14 fix sweep stop freq. setting
    [sweep.cpp]
2025-03-14 rework calibration
    - introduce a menu to run each part separately
    - use updated input for floats
    - added some sanity checks
    [calibration.cpp]
2025-03-15 move calibration structs to calibration.h
2025-03-22 introduce board class
2025-03-22 fine tuning calibration
2025-05-04 reduce max output level to prevent clipping
    [globals.h]
2025-05-04 some more tweaks to calibration routine
    requires some HW changes. see schematic v.1.1.
2025-05-04 add sanity check of headroom at current gain and range adjustment
2025-05-04 added PCB & PCBA + version subfolder
    [BOM_TeensyLCR_R1_v1.0.csv]
2025-05-04 added v1.1 schematic
    [BOM_TeensyLCR_R1_v1.1.csv]
2025-07-04 add phase correction depending on gain and frequency
    [calibration.cpp, calibration.h]
